greatfet-hardware/begonia/begonia.kicad_pcb

## KiCad design begonia.kicad_pcb (2019-05-27)

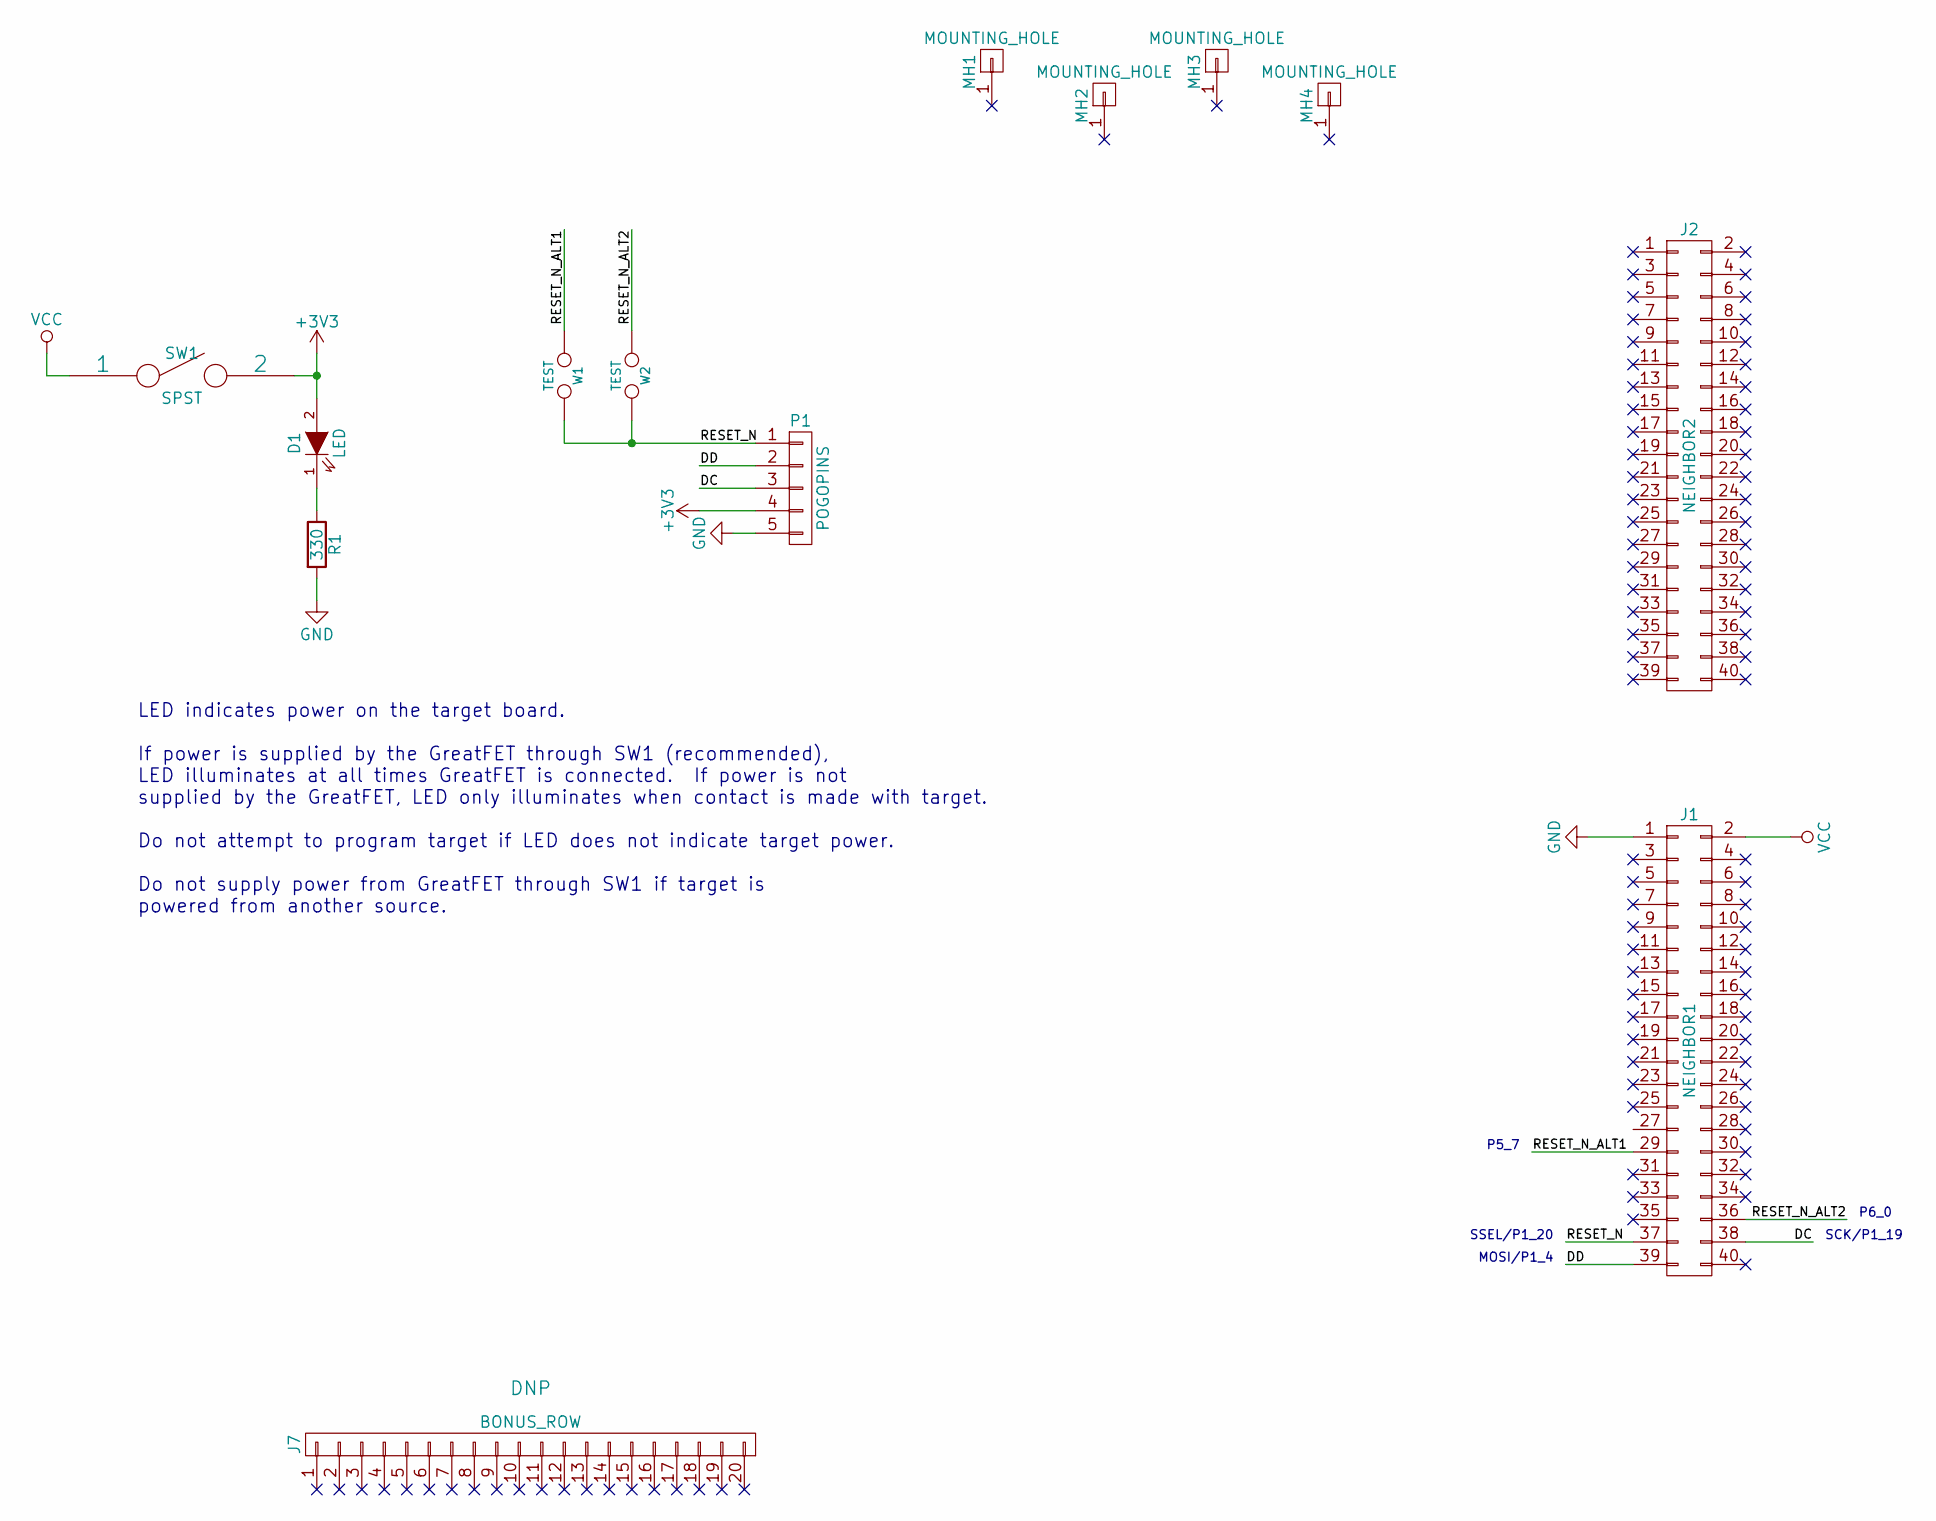
[picture p1: schematic begonia.sch, GreatFET Begonia, a GIMME Neighbor for GreatFET]

Parts:
D1: LED; 0603D; Part Number APT1608SGC
J1: NEIGHBOR1; HEADER-2x20; Part Number SSQ-120-23-G-D
J2: NEIGHBOR2; HEADER-2x20; Part Number SSQ-120-23-G-D
J7: BONUS_ROW; HEADER-1x20; Part Number SSQ-120-23-G-S
MH1, MH2, MH3, MH4: MOUNTING_HOLE; HOLE126MIL-COPPER
P1: POGOPINS; POGOPIN-5-IMME; Part Number PRT-09174
R1: 330; 0603; Part Number RMCF0603JT330R
SW1: SPST; SSSS810701; Part Number SSSS810701
W1, W2: TEST; 0603-JUMPER

Connections:
+3V3: D1.2 (A), P1.4, SW1.2
/DC: J1.38, P1.3
/DD: J1.39, P1.2
/RESET_N: J1.37, P1.1, W1.2, W2.2
/RESET_N_ALT1: J1.29, W1.1
/RESET_N_ALT2: J1.36, W2.1
GND: J1.1, P1.5, R1.2
unnamed: D1.1 (K), R1.1
VCC: J1.2, SW1.1

Notes on the sheet:
MOSI/P1_4
SCK/P1_19
SSEL/P1_20
LED indicates power on the target board. If power is supplied by the GreatFET through SW1 (recommended), LED illuminates at all times GreatFET is connected. If power is not supplied by the GreatFET, LED only illuminates when contact is made with target. Do not attempt to program target if LED does 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
P5_7
P6_0

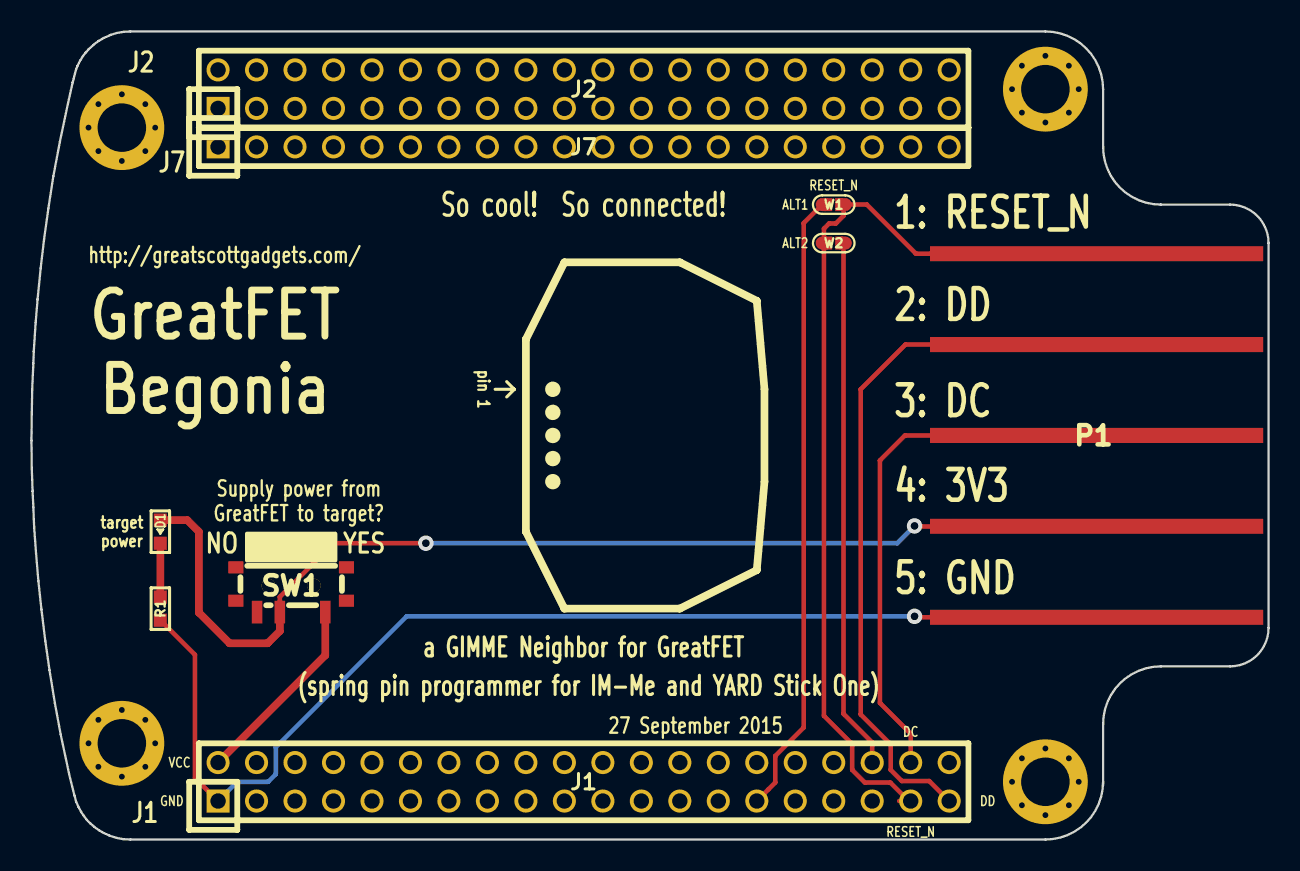
[picture p2: board begonia.kicad_pcb from above]

Board: 2 copper layers, 81.7 x 53.3 mm, 13 parts (0 on the bottom side), 9 nets.
