greatfet-hardware/begonia/(commit log)

2019-05-27 split begonia into separate repository
    [azalea.kicad_pcb, azalea.sch, begonia.kicad_pcb, begonia.sch, crocus.kicad_pcb, crocus.sch, daffodil.kicad_pcb, daffodil.sch]
2020-07-03 adopt OSHWA convention for SPI signal names https://www.oshwa.org/a-resolution-to-redefine-spi-signal-names
    [begonia.sch]
