greatfet-hardware/begonia/(notices)

Notices in the files:
begonia.sch:
Copyright 2015 Michael Ossmann
License: GPL v2
